Killerpk06/micromouse/kicad/micromouse_bom.csv

Reference | Value | Footprint | MPN | LCSC | Note | Qty
BZ1 | Magnetic 3V | Buzzer_Beeper:Buzzer_12x9.5RM7.6 |  |  |  | 1
C1 | 100uF 16V | Capacitor_Tantalum_SMD:CP_EIA-7343-31_Kemet-D |  |  |  | 1
C2,C3,C20 | 10uF 25V | Capacitor_SMD:C_1206_3216Metric |  |  |  | 3
C4,C7,C10,C11,C12,C15,C16,C19,C21,C23,C29,C31,C33,C35,C36,C38,C40,C42,C43,C44,C45,C46 | 100nF | Capacitor_SMD:C_0603_1608Metric |  |  |  | 22
C5,C6 | 22uF 10V | Capacitor_SMD:C_0805_2012Metric |  |  |  | 2
C8,C9,C14 | 1uF | Capacitor_SMD:C_0603_1608Metric |  |  |  | 3
C13,C28,C30,C32,C34 | 4.7uF | Capacitor_SMD:C_0603_1608Metric |  |  |  | 5
C17,C18 | 30pF C0G | Capacitor_SMD:C_0603_1608Metric |  |  |  | 2
C22 | 47uF 16V | Capacitor_Tantalum_SMD:CP_EIA-7343-31_Kemet-D |  |  |  | 1
C24,C25,C26,C27 | 100pF | Capacitor_SMD:C_0603_1608Metric |  |  |  | 4
C37 | 10nF | Capacitor_SMD:C_0603_1608Metric |  |  |  | 1
C39 | 2.2nF 50V | Capacitor_SMD:C_0603_1608Metric |  |  |  | 1
C41 | 4.7nF | Capacitor_SMD:C_0603_1608Metric |  |  |  | 1
D1 | Green | LED_SMD:LED_0603_1608Metric |  |  |  | 1
D2 | Blue | LED_SMD:LED_0603_1608Metric |  |  |  | 1
D3 | 1N4148W | Diode_SMD:D_SOD-123 | 1N4148W |  |  | 1
H1,H2,H3,H4 | M3 | MountingHole:MountingHole_3.2mm_M3_Pad_Via |  |  |  | 4
J1 | XT60PW-M | Connector_AMASS:AMASS_XT60PW-M_1x02_P7.20mm_Horizontal | XT60PW-M |  |  | 1
J2 | SWD 1.27mm | Connector_PinHeader_1.27mm:PinHeader_2x05_P1.27mm_Vertical_SMD |  |  |  | 1
J3 | SWD ST-Link | Connector_PinHeader_2.54mm:PinHeader_1x04_P2.54mm_Vertical |  |  |  | 1
J4 | MOTOR_L | Connector_JST:JST_PH_S6B-PH-K_1x06_P2.00mm_Horizontal | S6B-PH-K-S |  |  | 1
J5 | MOTOR_R | Connector_JST:JST_PH_S6B-PH-K_1x06_P2.00mm_Horizontal | S6B-PH-K-S |  |  | 1
J6 | FAN | Connector_JST:JST_PH_S2B-PH-K_1x02_P2.00mm_Horizontal | S2B-PH-K-S |  |  | 1
J7 | USB-C | Connector_USB:USB_C_Receptacle_GCT_USB4105-xx-A_16P_TopMnt_Horizontal | USB4105-GF-A |  |  | 1
J8 | OLED SSD1306 0.96in | Connector_PinHeader_2.54mm:PinHeader_1x04_P2.54mm_Vertical |  |  | Off-board 0.96in SSD1306 128x64 I2C module, addr 0x3C. REMOVE module SCL/SDA pull-ups: bus is 2.8V (+2V8 pull-ups R18/R19) | 1
L1 | 3.9uH | Inductor_SMD:L_Taiyo-Yuden_NR-40xx | NR4018T3R9M |  |  | 1
Q1 | AO3400A | Package_TO_SOT_SMD:SOT-23 | AO3400A |  |  | 1
Q2 | MMBT3904 | Package_TO_SOT_SMD:SOT-23 | MMBT3904 |  |  | 1
R1 | 20k 1% | Resistor_SMD:R_0603_1608Metric |  |  |  | 1
R2 | 10k 1% | Resistor_SMD:R_0603_1608Metric |  |  |  | 1
R3,R35,R36 | 1k | Resistor_SMD:R_0603_1608Metric |  |  |  | 3
R4,R5,R6,R7,R8,R9,R10,R11,R20,R21,R24,R25,R26,R33,R34,R37,R38,R39,R40 | 10k | Resistor_SMD:R_0603_1608Metric |  |  |  | 19
R12,R13,R14,R15 | 4.7k | Resistor_SMD:R_0603_1608Metric |  |  |  | 4
R16 | 100 | Resistor_SMD:R_0603_1608Metric |  |  |  | 1
R17 | 100k | Resistor_SMD:R_0603_1608Metric |  |  |  | 1
R18,R19 | 2.2k | Resistor_SMD:R_0603_1608Metric |  |  |  | 2
R22,R23 | 47k | Resistor_SMD:R_0603_1608Metric |  |  |  | 2
R27,R28 | 5.1k | Resistor_SMD:R_0603_1608Metric |  |  |  | 2
R29 | 1M | Resistor_SMD:R_0603_1608Metric |  |  |  | 1
R30,R31 | 22 | Resistor_SMD:R_0603_1608Metric |  |  |  | 2
R32 | 1.5k | Resistor_SMD:R_0603_1608Metric |  |  |  | 1
SW1 | PCM12SMTR | Button_Switch_SMD:SW_SPDT_PCM12 | PCM12SMTR |  |  | 1
SW2 | RESET | Button_Switch_SMD:SW_SPST_TL3342 | TL3342F160QG |  |  | 1
SW3 | SW_A | Button_Switch_SMD:SW_SPST_TL3342 | TL3342F160QG |  |  | 1
SW4 | SW_B | Button_Switch_SMD:SW_SPST_TL3342 | TL3342F160QG |  |  | 1
SW5 | SW_UP | Button_Switch_SMD:SW_SPST_TL3342 | TL3342F160QG |  |  | 1
SW6 | SW_DOWN | Button_Switch_SMD:SW_SPST_TL3342 | TL3342F160QG |  |  | 1
SW7 | SW_BACK | Button_Switch_SMD:SW_SPST_TL3342 | TL3342F160QG |  |  | 1
SW8 | SW_ENTER | Button_Switch_SMD:SW_SPST_TL3342 | TL3342F160QG |  |  | 1
TP1 | VBAT_SW | TestPoint:TestPoint_Pad_D1.5mm |  |  |  | 1
TP2 | +3V3 | TestPoint:TestPoint_Pad_D1.5mm |  |  |  | 1
TP3,TP21 | GND | TestPoint:TestPoint_Pad_D1.5mm |  |  |  | 2
TP4 | BOOT0 | TestPoint:TestPoint_Pad_D1.5mm |  |  |  | 1
TP5 | BTN_UP | TestPoint:TestPoint_Pad_D1.5mm |  |  |  | 1
TP6 | BTN_DOWN | TestPoint:TestPoint_Pad_D1.5mm |  |  |  | 1
TP7 | BTN_BACK | TestPoint:TestPoint_Pad_D1.5mm |  |  |  | 1
TP8 | BTN_ENTER | TestPoint:TestPoint_Pad_D1.5mm |  |  |  | 1
TP9 | SPARE_PB1 | TestPoint:TestPoint_Pad_D1.5mm |  |  |  | 1
TP10 | I2C1_SCL | TestPoint:TestPoint_Pad_D1.5mm |  |  |  | 1
TP11 | I2C1_SDA | TestPoint:TestPoint_Pad_D1.5mm |  |  |  | 1
TP12 | TOF_XSHUT_FL | TestPoint:TestPoint_Pad_D1.5mm |  |  |  | 1
TP13 | TOF_GPIO1_FL | TestPoint:TestPoint_Pad_D1.5mm |  |  |  | 1
TP14 | TOF_XSHUT_FR | TestPoint:TestPoint_Pad_D1.5mm |  |  |  | 1
TP15 | TOF_GPIO1_FR | TestPoint:TestPoint_Pad_D1.5mm |  |  |  | 1
TP16 | TOF_XSHUT_L | TestPoint:TestPoint_Pad_D1.5mm |  |  |  | 1
TP17 | TOF_GPIO1_L | TestPoint:TestPoint_Pad_D1.5mm |  |  |  | 1
TP18 | TOF_XSHUT_R | TestPoint:TestPoint_Pad_D1.5mm |  |  |  | 1
TP19 | TOF_GPIO1_R | TestPoint:TestPoint_Pad_D1.5mm |  |  |  | 1
TP20 | IMU_INT | TestPoint:TestPoint_Pad_D1.5mm |  |  |  | 1
U1 | AP63203WU-7 | Package_TO_SOT_SMD:TSOT-23-6 | AP63203WU-7 |  |  | 1
U2 | ME6211C28M5G-N | Package_TO_SOT_SMD:SOT-23-5 | ME6211C28M5G-N |  |  | 1
U3 | STM32F103C8T6 | Package_QFP:LQFP-48_7x7mm_P0.5mm | STM32F103C8T6 |  |  | 1
U4 | TB6612FNG | Package_SO:SSOP-24_5.3x8.2mm_P0.65mm | TB6612FNG,C,8,EL |  |  | 1
U5,U6 | VL53L0X | Sensor_Distance:ST_VL53L1x | VL53L0CXV0DH/1 |  |  | 2
U7,U8 | VL6180X | micromouse:ST_VL6180X_LGA-12 | VL6180XV0NR/1 |  |  | 2
U9 | MPU-6050 | Sensor_Motion:InvenSense_QFN-24_4x4mm_P0.5mm | MPU-6050 |  |  | 1
U10 | W25Q32JVSSIQ | Package_SO:SOIC-8_5.3x5.3mm_P1.27mm | W25Q32JVSSIQ |  |  | 1
Y1 | 8MHz CL=20pF | Crystal:Crystal_SMD_3225-4Pin_3.2x2.5mm | X322508MSB4SI |  |  | 1
