Killerpk06/micromouse/kicad/micromouse.kicad_sch

## KiCad design kicad/micromouse.kicad_sch (2026-10-27)

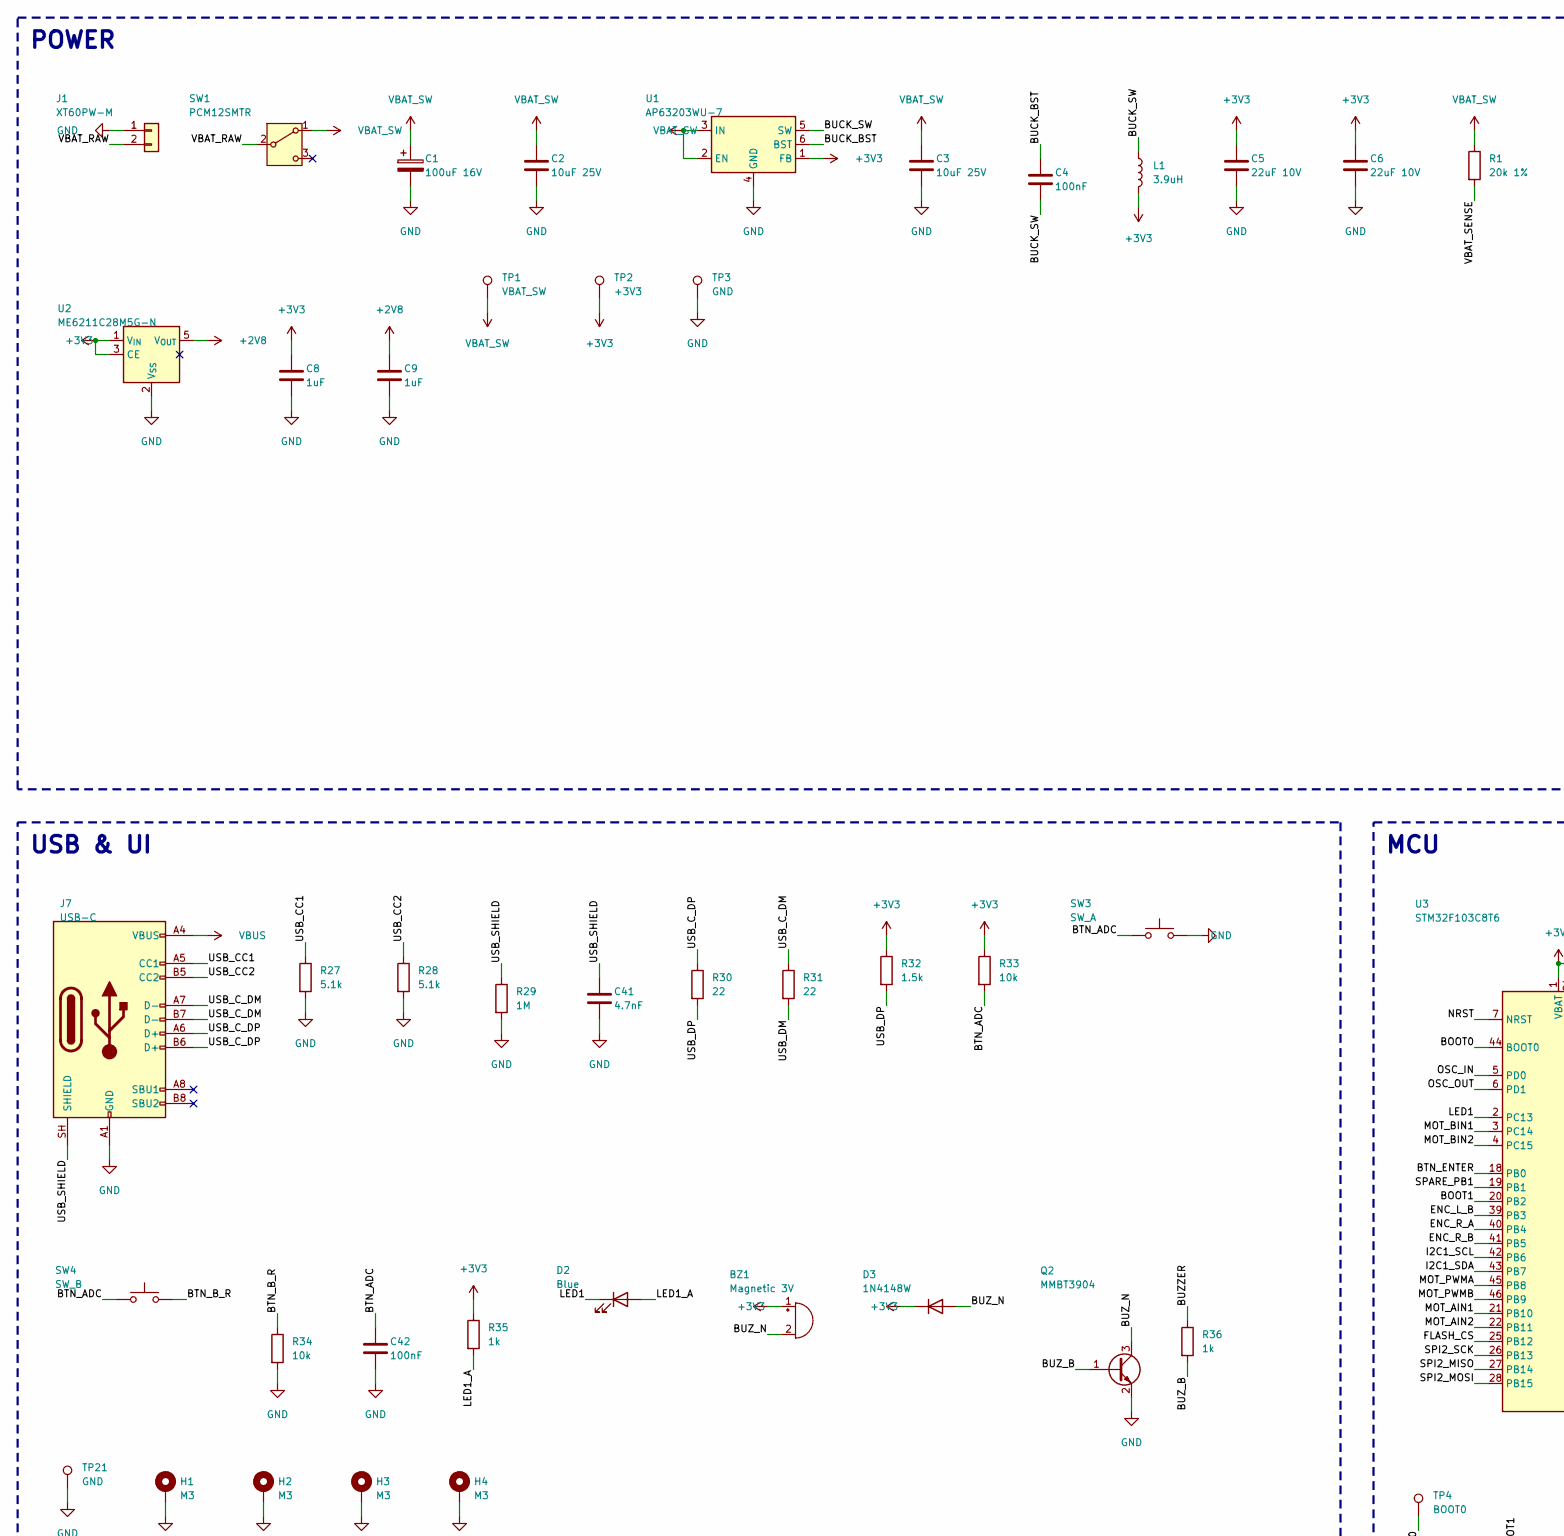
[picture p1: schematic micromouse.kicad_sch, part in row 1, column 1]

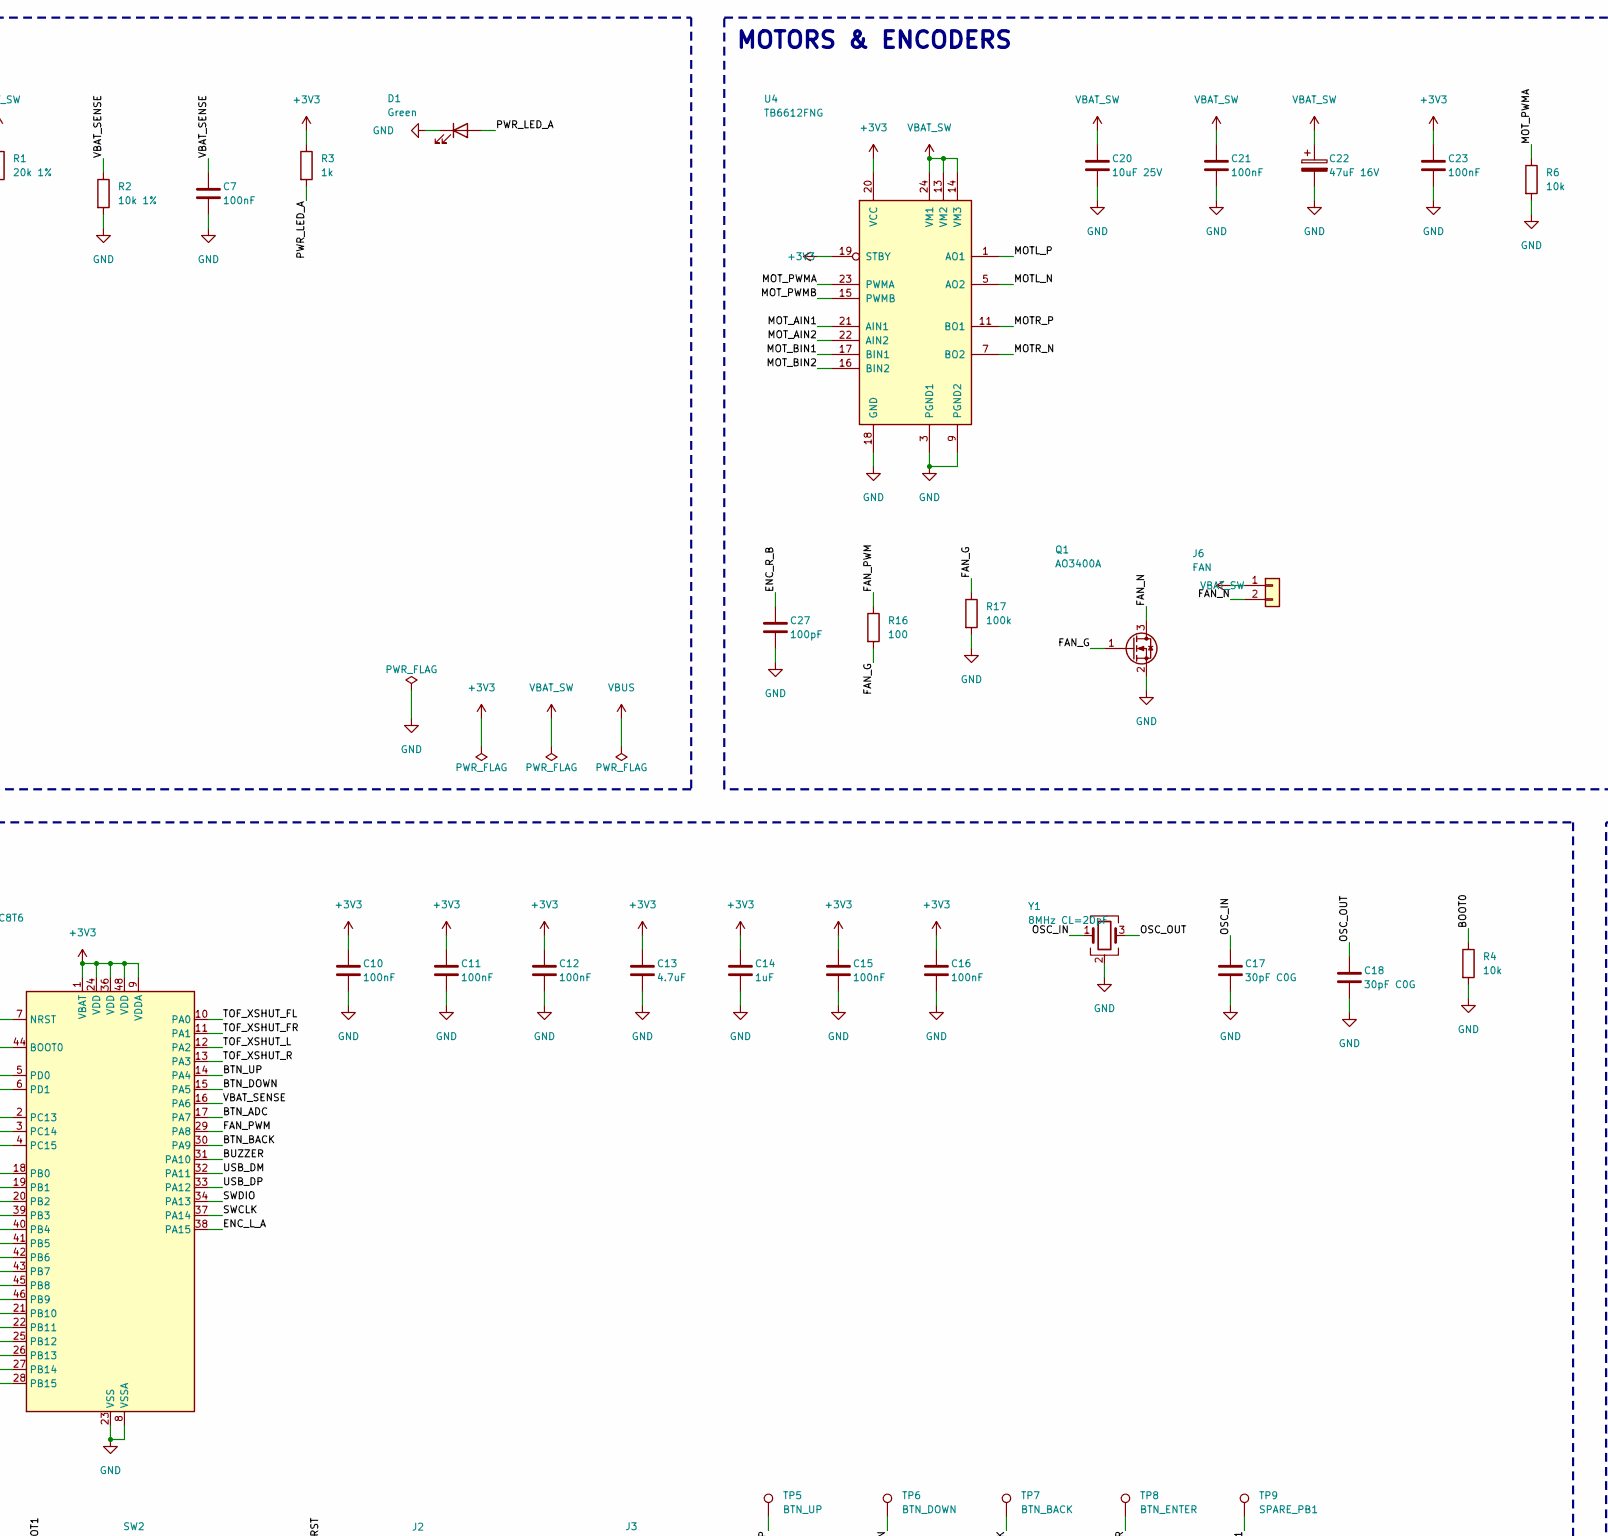
[picture p2: schematic micromouse.kicad_sch, part in row 1, column 2]

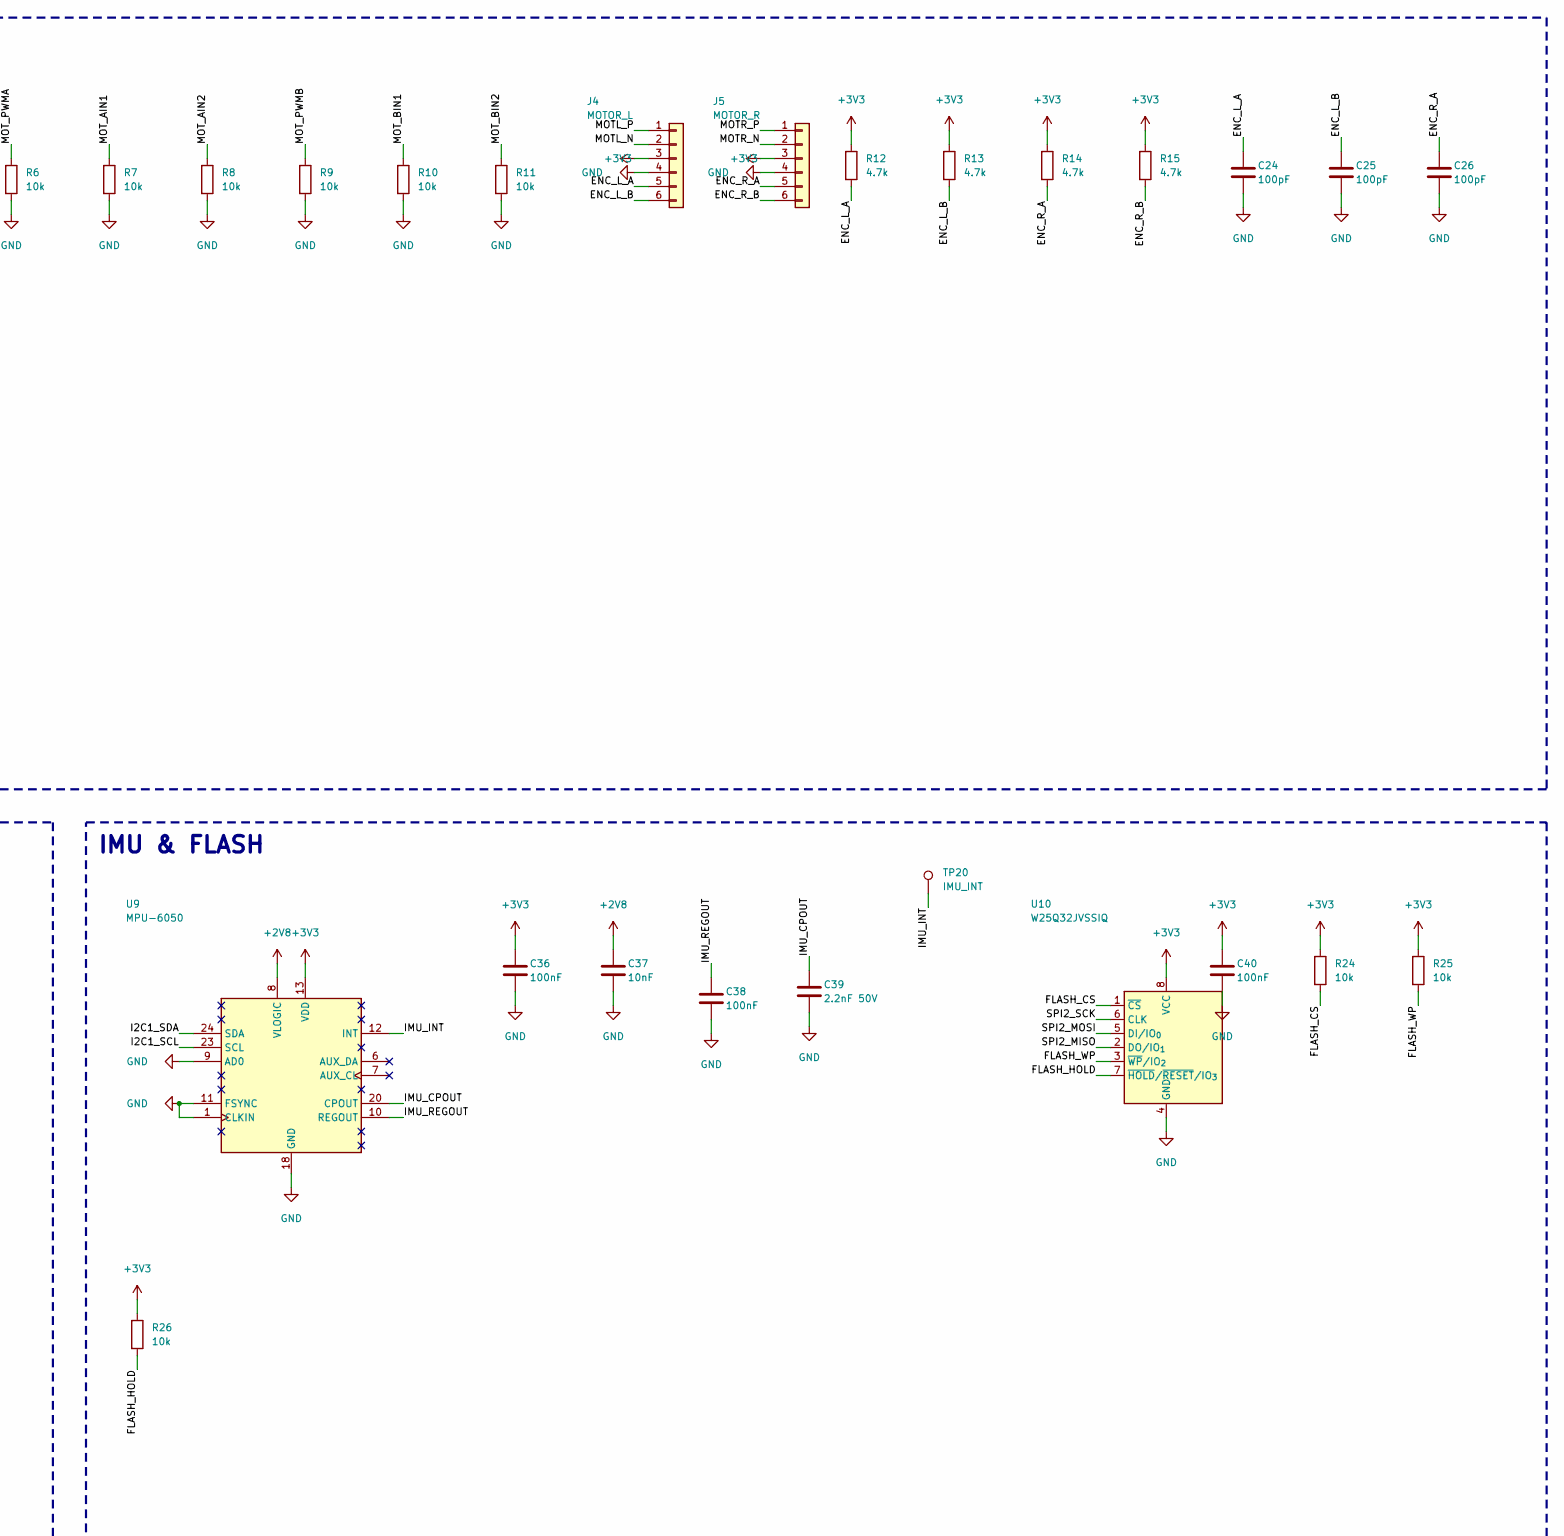
[picture p3: schematic micromouse.kicad_sch, part in row 1, column 3]

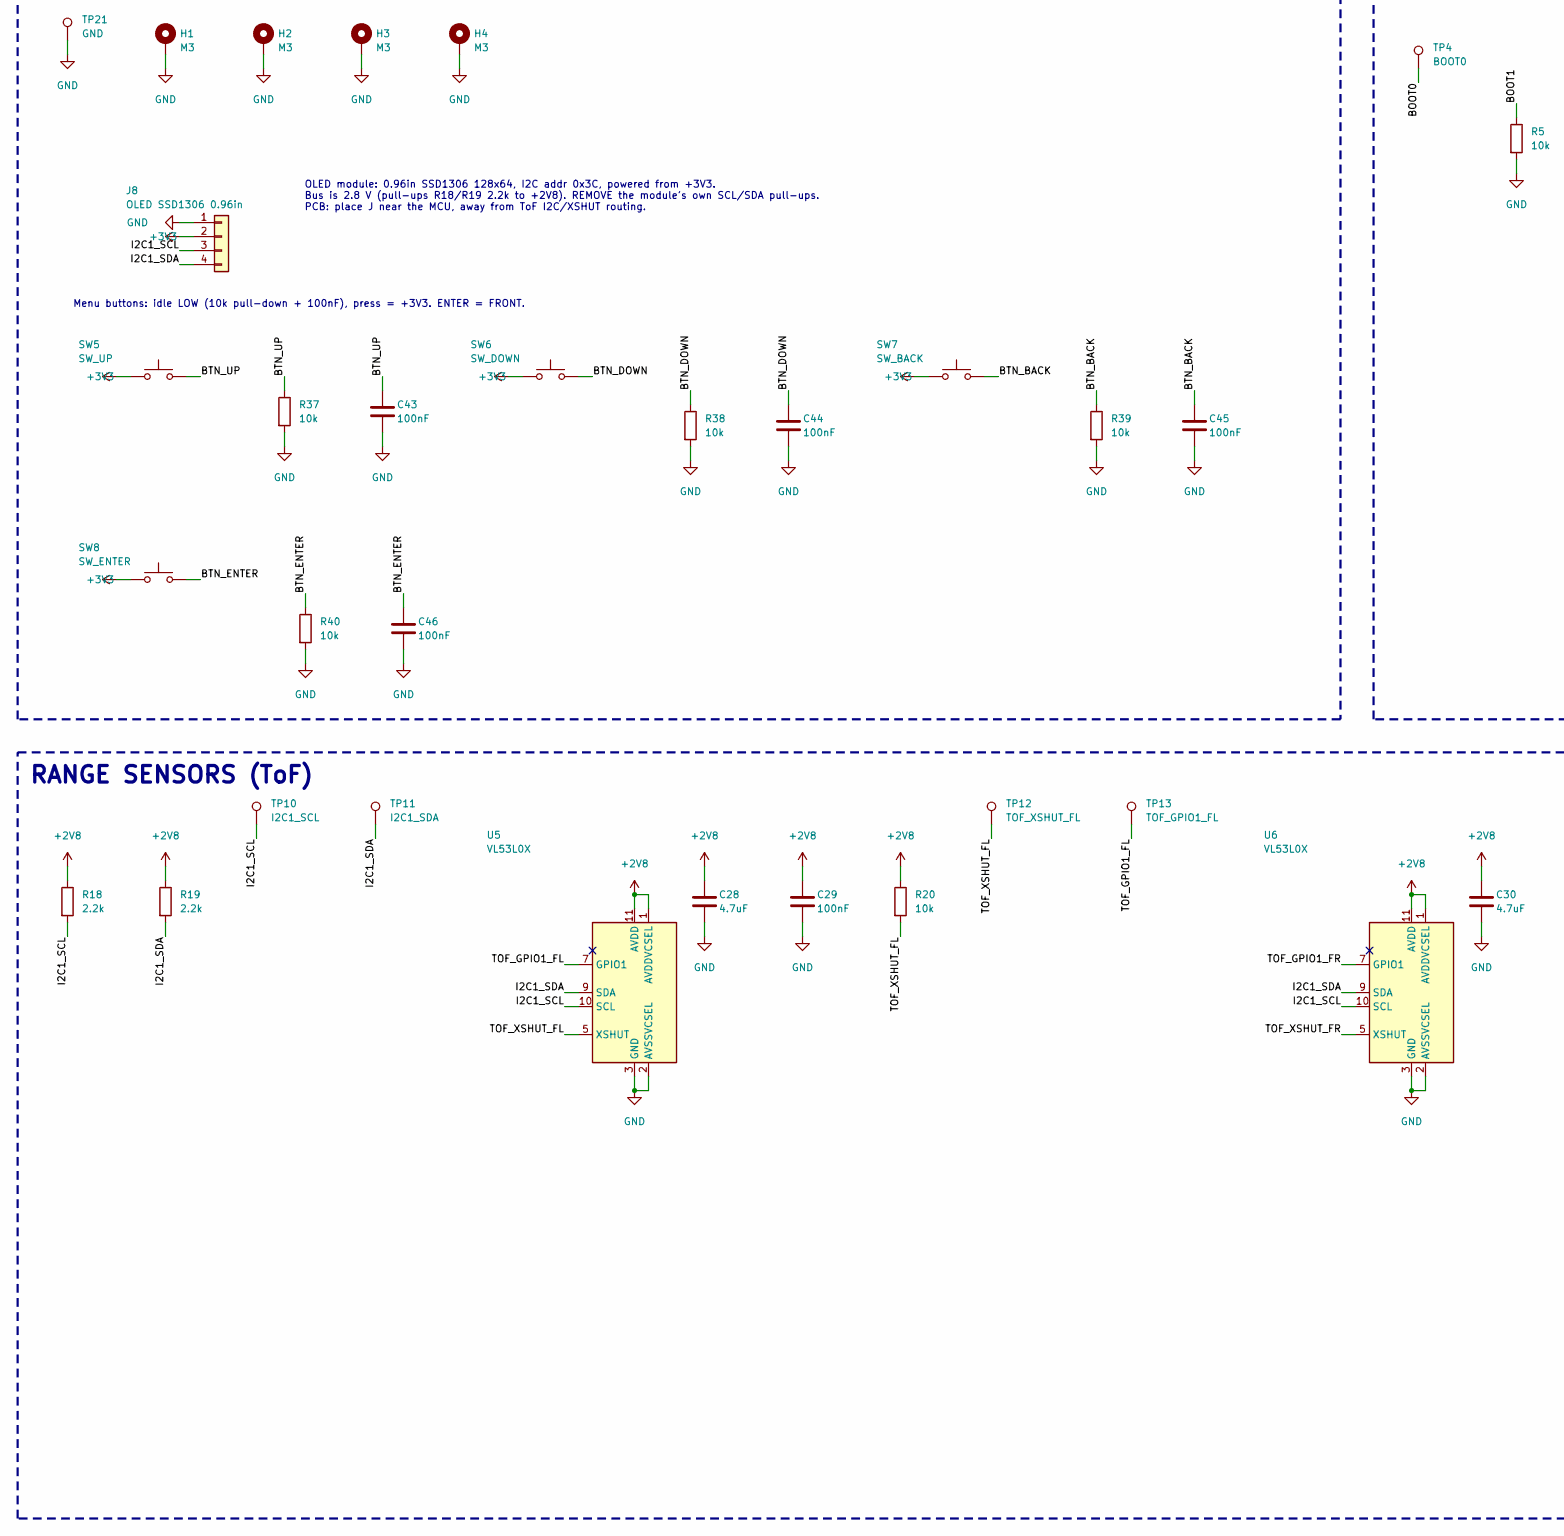
[picture p4: schematic micromouse.kicad_sch, part in row 2, column 1]

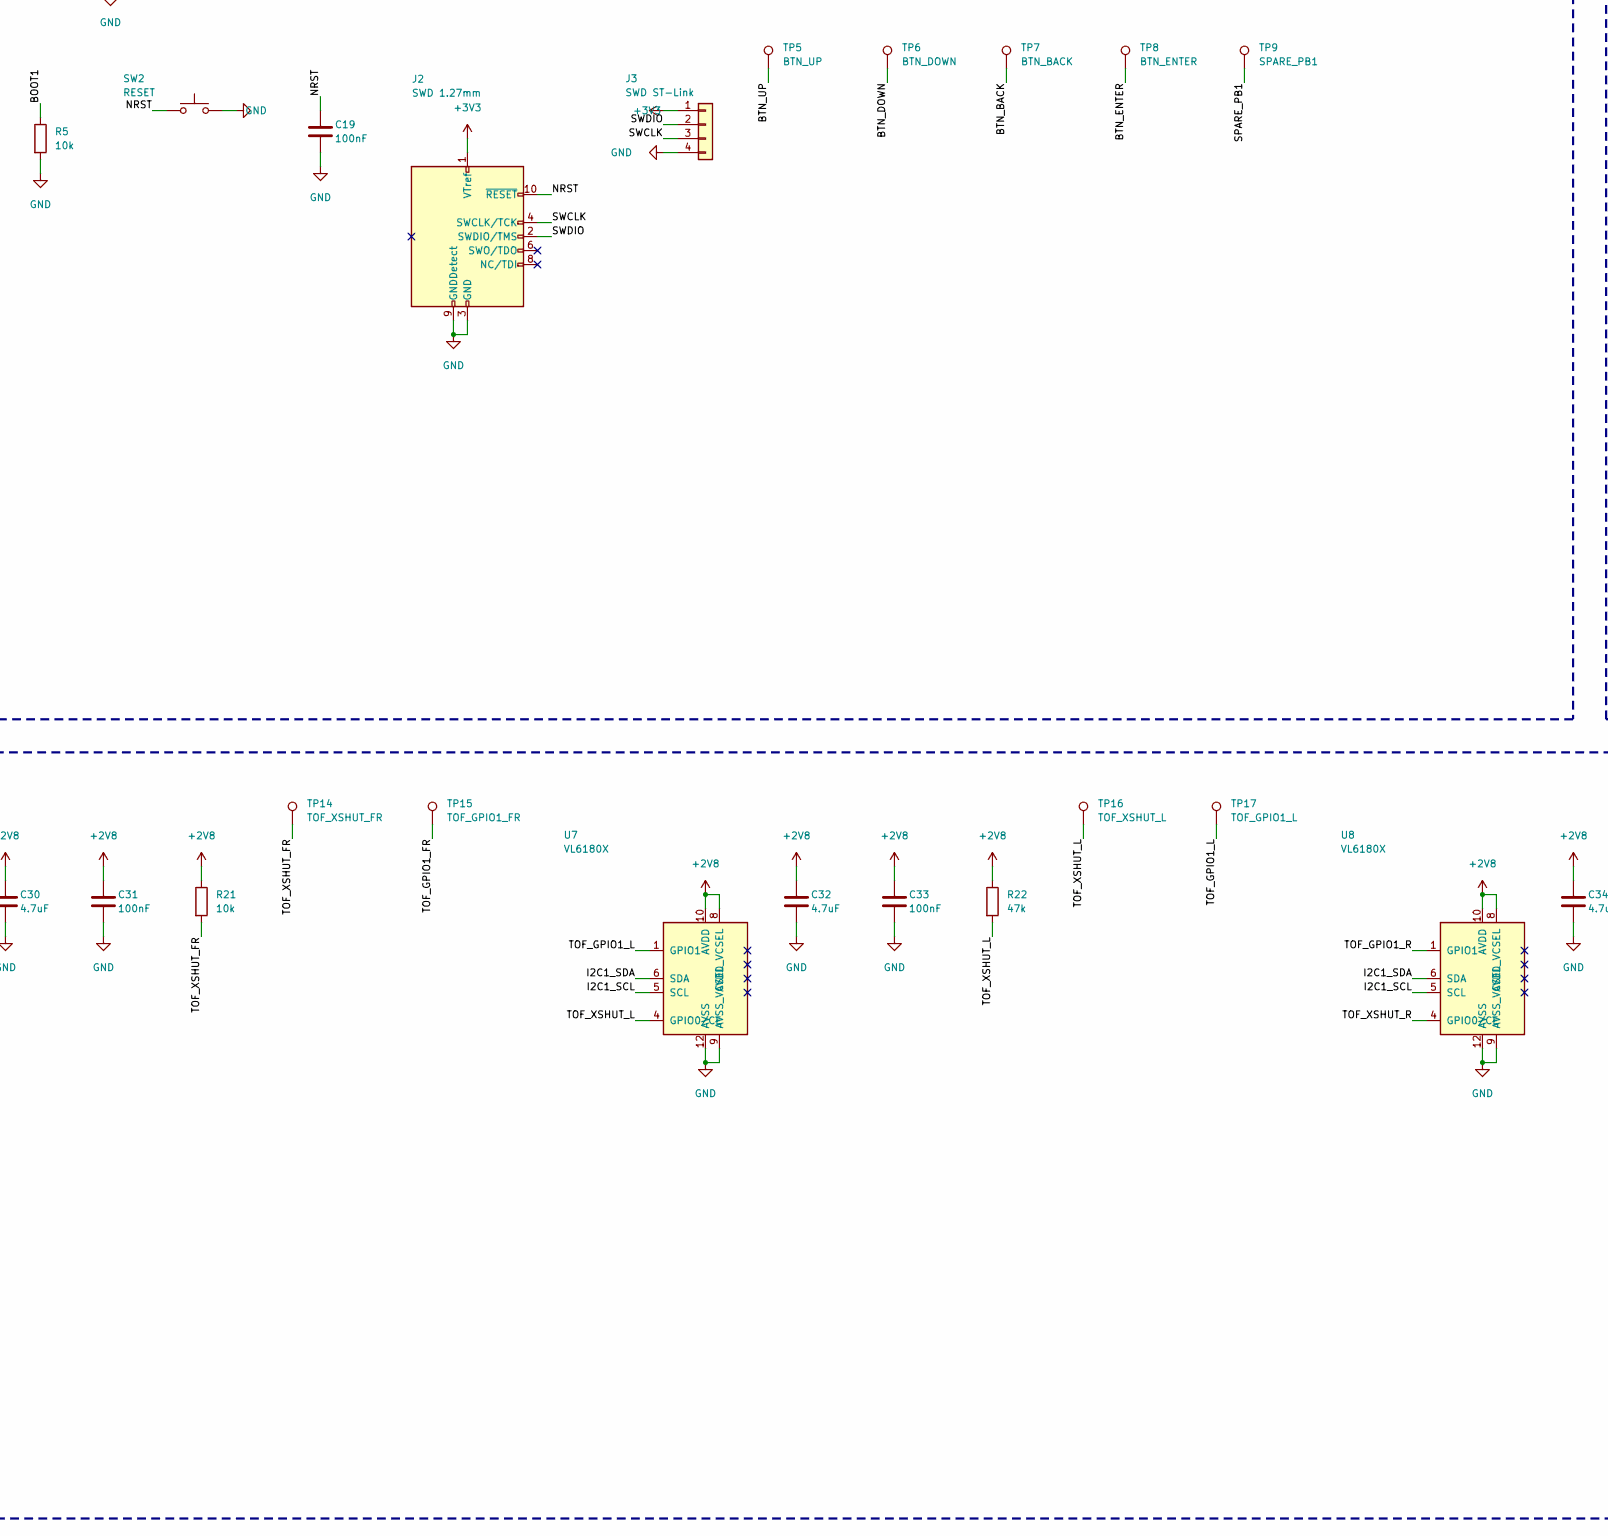
[picture p5: schematic micromouse.kicad_sch, part in row 2, column 2]

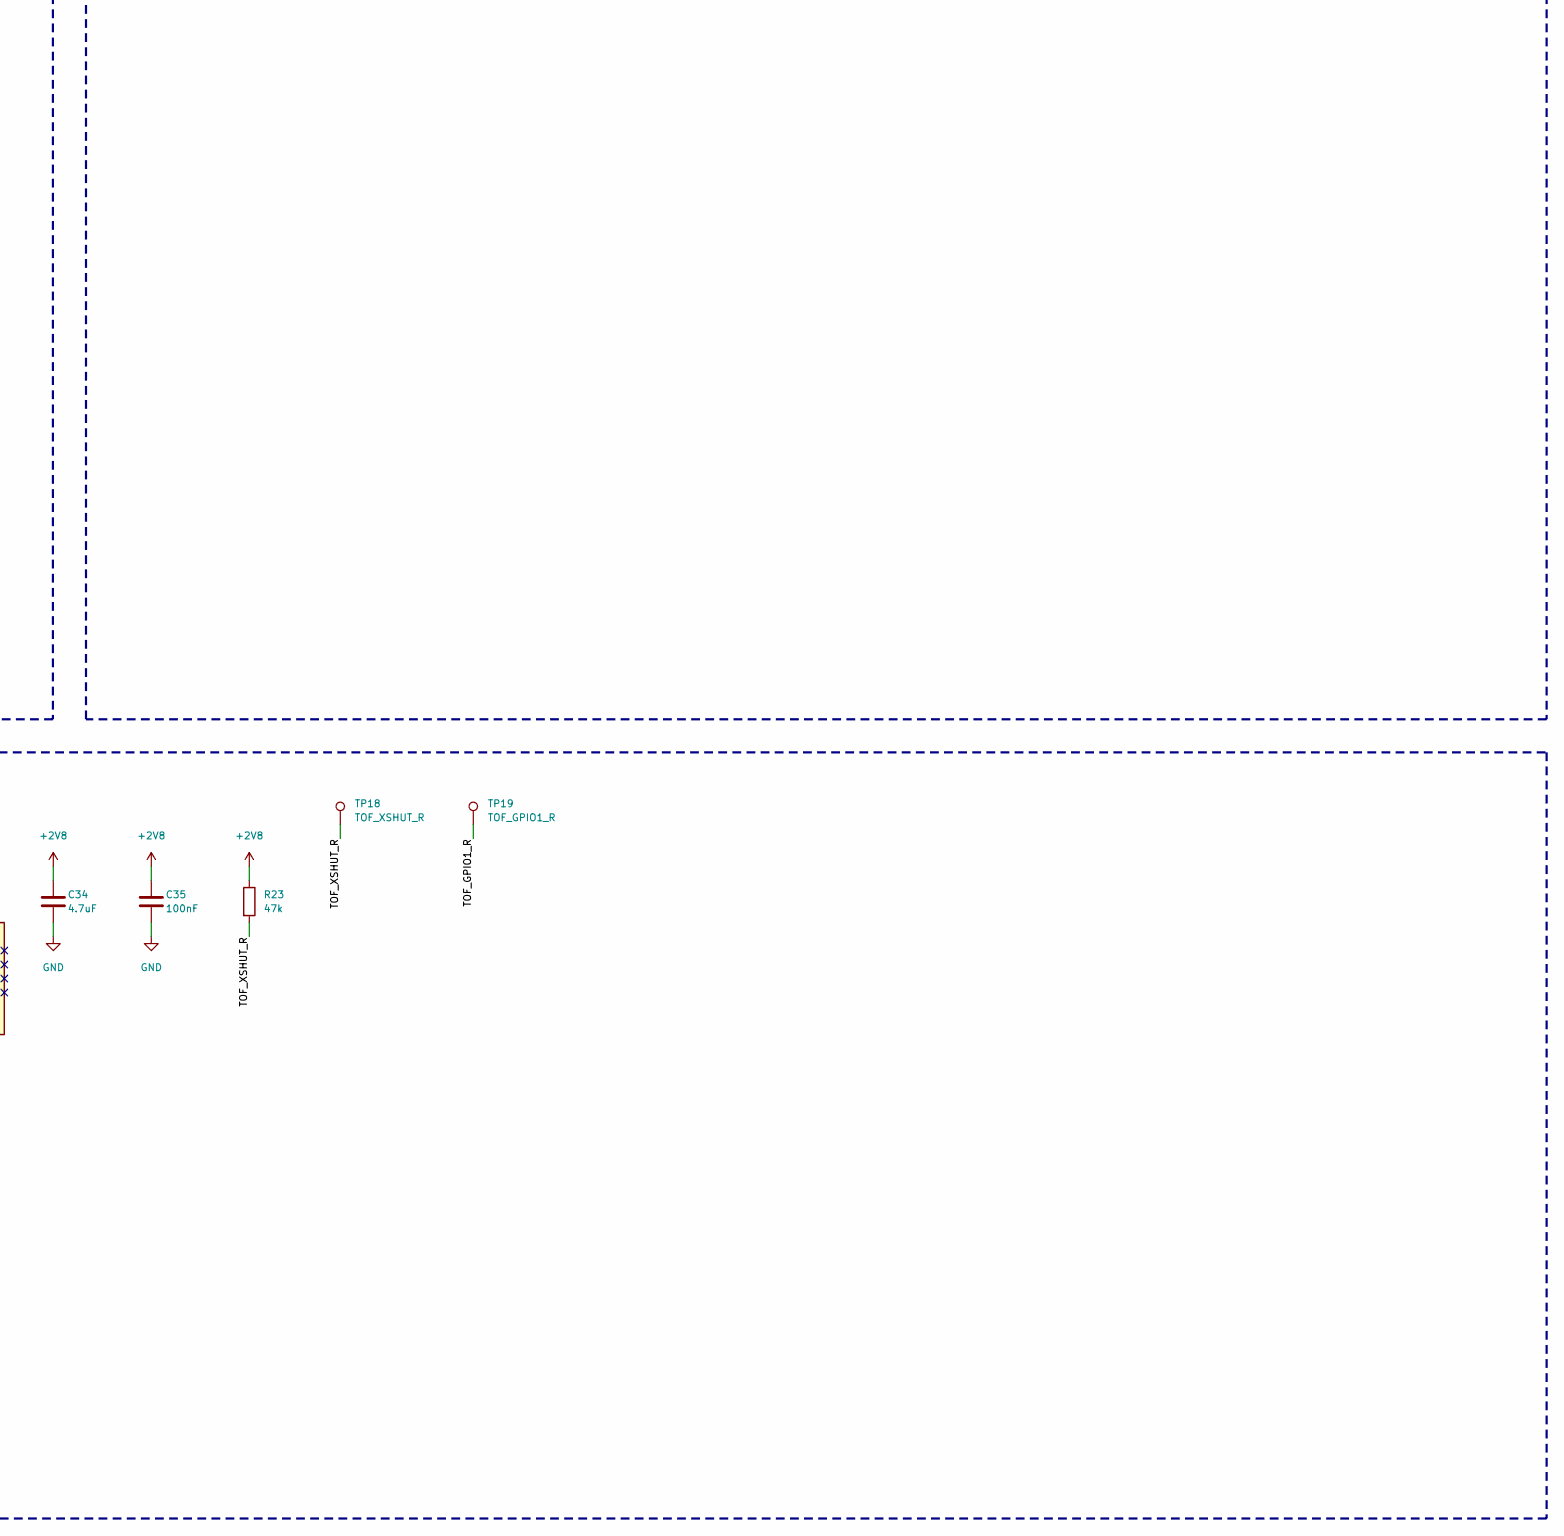
[picture p6: schematic micromouse.kicad_sch, part in row 2, column 3]

Parts:
BZ1: Magnetic 3V; Buzzer_12x9.5RM7.6
C1: 100uF 16V; CP_EIA-7343-31_Kemet-D
C2, C3, C20: 10uF 25V; C_1206_3216Metric
C4, C7, C10, C11, C12, C15, C16, C19, C21, C23, C29, C31, C33, C35, C36, C38, C40, C42, C43, C44, C45, C46: 100nF; C_0603_1608Metric
C5, C6: 22uF 10V; C_0805_2012Metric
C8, C9, C14: 1uF; C_0603_1608Metric
C13, C28, C30, C32, C34: 4.7uF; C_0603_1608Metric
C17, C18: 30pF C0G; C_0603_1608Metric
C22: 47uF 16V; CP_EIA-7343-31_Kemet-D
C24, C25, C26, C27: 100pF; C_0603_1608Metric
C37: 10nF; C_0603_1608Metric
C39: 2.2nF 50V; C_0603_1608Metric
C41: 4.7nF; C_0603_1608Metric
D1: Green; LED_0603_1608Metric
D2: Blue; LED_0603_1608Metric
D3: 1N4148W; D_SOD-123; MPN 1N4148W
H1, H2, H3, H4: M3; MountingHole_3.2mm_M3_Pad_Via
J1: XT60PW-M; AMASS_XT60PW-M_1x02_P7.20mm_Horizontal; MPN XT60PW-M
J2: SWD 1.27mm; PinHeader_2x05_P1.27mm_Vertical_SMD
J3: SWD ST-Link; PinHeader_1x04_P2.54mm_Vertical
J4: MOTOR_L; JST_PH_S6B-PH-K_1x06_P2.00mm_Horizontal; MPN S6B-PH-K-S
J5: MOTOR_R; JST_PH_S6B-PH-K_1x06_P2.00mm_Horizontal; MPN S6B-PH-K-S
J6: FAN; JST_PH_S2B-PH-K_1x02_P2.00mm_Horizontal; MPN S2B-PH-K-S
J7: USB-C; USB_C_Receptacle_GCT_USB4105-xx-A_16P_TopMnt_Horizontal; MPN USB4105-GF-A
J8: OLED SSD1306 0.96in; PinHeader_1x04_P2.54mm_Vertical
L1: 3.9uH; L_Taiyo-Yuden_NR-40xx; MPN NR4018T3R9M
Q1: AO3400A; SOT-23; MPN AO3400A
Q2: MMBT3904; SOT-23; MPN MMBT3904
R1: 20k 1%; R_0603_1608Metric
R2: 10k 1%; R_0603_1608Metric
R3, R35, R36: 1k; R_0603_1608Metric
R4, R5, R6, R7, R8, R9, R10, R11, R20, R21, R24, R25, R26, R33, R34, R37, R38, R39, R40: 10k; R_0603_1608Metric
R12, R13, R14, R15: 4.7k; R_0603_1608Metric
R16: 100; R_0603_1608Metric
R17: 100k; R_0603_1608Metric
R18, R19: 2.2k; R_0603_1608Metric
R22, R23: 47k; R_0603_1608Metric
R27, R28: 5.1k; R_0603_1608Metric
R29: 1M; R_0603_1608Metric
R30, R31: 22; R_0603_1608Metric
R32: 1.5k; R_0603_1608Metric
SW1: PCM12SMTR; SW_SPDT_PCM12; MPN PCM12SMTR
SW2: RESET; SW_SPST_TL3342; MPN TL3342F160QG
SW3: SW_A; SW_SPST_TL3342; MPN TL3342F160QG
SW4: SW_B; SW_SPST_TL3342; MPN TL3342F160QG
SW5: SW_UP; SW_SPST_TL3342; MPN TL3342F160QG
SW6: SW_DOWN; SW_SPST_TL3342; MPN TL3342F160QG
SW7: SW_BACK; SW_SPST_TL3342; MPN TL3342F160QG
SW8: SW_ENTER; SW_SPST_TL3342; MPN TL3342F160QG
TP1: VBAT_SW; TestPoint_Pad_D1.5mm
TP2: +3V3; TestPoint_Pad_D1.5mm
TP3, TP21: GND; TestPoint_Pad_D1.5mm
TP4: BOOT0; TestPoint_Pad_D1.5mm
TP5: BTN_UP; TestPoint_Pad_D1.5mm
TP6: BTN_DOWN; TestPoint_Pad_D1.5mm
TP7: BTN_BACK; TestPoint_Pad_D1.5mm
TP8: BTN_ENTER; TestPoint_Pad_D1.5mm
TP9: SPARE_PB1; TestPoint_Pad_D1.5mm
TP10: I2C1_SCL; TestPoint_Pad_D1.5mm
TP11: I2C1_SDA; TestPoint_Pad_D1.5mm
TP12: TOF_XSHUT_FL; TestPoint_Pad_D1.5mm
TP13: TOF_GPIO1_FL; TestPoint_Pad_D1.5mm
TP14: TOF_XSHUT_FR; TestPoint_Pad_D1.5mm
TP15: TOF_GPIO1_FR; TestPoint_Pad_D1.5mm
TP16: TOF_XSHUT_L; TestPoint_Pad_D1.5mm
TP17: TOF_GPIO1_L; TestPoint_Pad_D1.5mm
TP18: TOF_XSHUT_R; TestPoint_Pad_D1.5mm
TP19: TOF_GPIO1_R; TestPoint_Pad_D1.5mm
TP20: IMU_INT; TestPoint_Pad_D1.5mm
U1: AP63203WU-7; TSOT-23-6; MPN AP63203WU-7
U2: ME6211C28M5G-N; SOT-23-5; MPN ME6211C28M5G-N
U3: STM32F103C8T6; LQFP-48_7x7mm_P0.5mm; MPN STM32F103C8T6
U4: TB6612FNG; SSOP-24_5.3x8.2mm_P0.65mm; MPN TB6612FNG,C,8,EL
U5, U6: VL53L0X; ST_VL53L1x; MPN VL53L0CXV0DH/1
U7, U8: VL6180X; ST_VL6180X_LGA-12; MPN VL6180XV0NR/1
U9: MPU-6050; InvenSense_QFN-24_4x4mm_P0.5mm; MPN MPU-6050
U10: W25Q32JVSSIQ; SOIC-8_5.3x5.3mm_P1.27mm; MPN W25Q32JVSSIQ
Y1: 8MHz CL=20pF; Crystal_SMD_3225-4Pin_3.2x2.5mm; MPN X322508MSB4SI

Connections:
+2V8: C9.1, C28.1, C29.1, C30.1, C31.1, C32.1, C33.1, C34.1, C35.1, C37.1, R18.1, R19.1, R20.1, R21.1, R22.1, R23.1, U2.5 (V_{OUT}), U5.1 (AVDDVCSEL), U5.11 (AVDD), U6.1 (AVDDVCSEL), U6.11 (AVDD), U7.8 (AVDD_VCSEL), U7.10 (AVDD), U8.8 (AVDD_VCSEL), U8.10 (AVDD), U9.8 (VLOGIC)
+3V3: BZ1.1 (+), C5.1, C6.1, C8.1, C10.1, C11.1, C12.1, C13.1, C14.1, C15.1, C16.1, C23.1, C36.1, C40.1, D3.1 (K), J2.1 (VTref), J3.1, J4.3, J5.3, J8.2, L1.2, R3.1, R12.1, R13.1, R14.1, R15.1, R24.1, R25.1, R26.1, R32.1, R33.1, R35.1, SW5.1, SW6.1, SW7.1, SW8.1, TP2.1, U1.1 (FB), U2.1 (V_{IN}), U2.3 (CE), U3.1 (VBAT), U3.9 (VDDA), U3.24 (VDD), U3.36 (VDD), U3.48 (VDD), U4.19 (STBY), U4.20 (VCC), U9.13 (VDD), U10.8 (VCC)
BOOT0: R4.1, TP4.1, U3.44 (BOOT0)
BOOT1: R5.1, U3.20 (PB2)
BTN_ADC: C42.1, R33.2, SW3.1, SW4.1, U3.17 (PA7)
BTN_BACK: C45.1, R39.1, SW7.2, TP7.1, U3.30 (PA9)
BTN_B_R: R34.1, SW4.2
BTN_DOWN: C44.1, R38.1, SW6.2, TP6.1, U3.15 (PA5)
BTN_ENTER: C46.1, R40.1, SW8.2, TP8.1, U3.18 (PB0)
BTN_UP: C43.1, R37.1, SW5.2, TP5.1, U3.14 (PA4)
BUCK_BST: C4.1, U1.6 (BST)
BUCK_SW: C4.2, L1.1, U1.5 (SW)
BUZZER: R36.1, U3.31 (PA10)
BUZ_B: Q2.1 (B), R36.2
BUZ_N: BZ1.2 (-), D3.2 (A), Q2.3 (C)
ENC_L_A: C24.1, J4.5, R12.2, U3.38 (PA15)
ENC_L_B: C25.1, J4.6, R13.2, U3.39 (PB3)
ENC_R_A: C26.1, J5.5, R14.2, U3.40 (PB4)
ENC_R_B: C27.1, J5.6, R15.2, U3.41 (PB5)
FAN_G: Q1.1 (G), R16.2, R17.1
FAN_N: J6.2, Q1.3 (D)
FAN_PWM: R16.1, U3.29 (PA8)
FLASH_CS: R24.2, U3.25 (PB12), U10.1 (~CS)
FLASH_HOLD: R26.2, U10.7 (~HOLD/~RESET/IO_{3})
FLASH_WP: R25.2, U10.3 (~WP/IO_{2})
GND: C1.2, C2.2, C3.2, C5.2, C6.2, C7.2, C8.2, C9.2, C10.2, C11.2, C12.2, C13.2, C14.2, C15.2, C16.2, C17.2, C18.2, C19.2, C20.2, C21.2, C22.2, C23.2, C24.2, C25.2, C26.2, C27.2, C28.2, C29.2, C30.2, C31.2, C32.2, C33.2, C34.2, C35.2, C36.2, C37.2, C38.2, C39.2, C40.2, C41.2, C42.2, C43.2, C44.2, C45.2, C46.2, D1.1 (K), H1.1, H2.1, H3.1, H4.1, J1.1, J2.3 (GND), J2.5 (GND), J2.9 (GNDDetect), J3.4, J4.4, J5.4, J7.A1 (GND), J7.A12 (GND), J7.B1 (GND), J7.B12 (GND), J8.1, Q1.2 (S), Q2.2 (E), R2.2, R4.2, R5.2, R6.2, R7.2, R8.2, R9.2, R10.2, R11.2, R17.2, R27.2, R28.2, R29.2, R34.2, R37.2, R38.2, R39.2, R40.2, SW2.2, SW3.2, TP3.1, TP21.1, U1.4 (GND), U2.2 (V_{SS}), U3.8 (VSSA), U3.23 (VSS), U3.35 (VSS), U3.47 (VSS), U4.3 (PGND1), U4.4 (PGND1), U4.9 (PGND2), U4.10 (PGND2), U4.18 (GND), U5.2 (AVSSVCSEL), U5.3 (GND), U5.4 (GND), U5.6 (GND), U5.12 (GND), U6.2 (AVSSVCSEL), U6.3 (GND), U6.4 (GND), U6.6 (GND), U6.12 (GND), U7.9 (AVSS_VCSEL), U7.12 (AVSS), U8.9 (AVSS_VCSEL), U8.12 (AVSS), U9.1 (CLKIN), U9.9 (AD0), U9.11 (FSYNC), U9.18 (GND), U10.4 (GND), Y1.2 (G), Y1.4 (G)
I2C1_SCL: J8.3, R18.2, TP10.1, U3.42 (PB6), U5.10 (SCL), U6.10 (SCL), U7.5 (SCL), U8.5 (SCL), U9.23 (SCL)
I2C1_SDA: J8.4, R19.2, TP11.1, U3.43 (PB7), U5.9 (SDA), U6.9 (SDA), U7.6 (SDA), U8.6 (SDA), U9.24 (SDA)
IMU_CPOUT: C39.1, U9.20 (CPOUT)
IMU_INT: TP20.1, U9.12 (INT)
IMU_REGOUT: C38.1, U9.10 (REGOUT)
LED1: D2.1 (K), U3.2 (PC13)
LED1_A: D2.2 (A), R35.2
MOTL_N: J4.2, U4.5 (AO2), U4.6 (AO2)
MOTL_P: J4.1, U4.1 (AO1), U4.2 (AO1)
MOTR_N: J5.2, U4.7 (BO2), U4.8 (BO2)
MOTR_P: J5.1, U4.11 (BO1), U4.12 (BO1)
MOT_AIN1: R7.1, U3.21 (PB10), U4.21 (AIN1)
MOT_AIN2: R8.1, U3.22 (PB11), U4.22 (AIN2)
MOT_BIN1: R10.1, U3.3 (PC14), U4.17 (BIN1)
MOT_BIN2: R11.1, U3.4 (PC15), U4.16 (BIN2)
MOT_PWMA: R6.1, U3.45 (PB8), U4.23 (PWMA)
MOT_PWMB: R9.1, U3.46 (PB9), U4.15 (PWMB)
NRST: C19.1, J2.10 (~RESET), SW2.1, U3.7 (NRST)
OSC_IN: C17.1, U3.5 (PD0), Y1.1
OSC_OUT: C18.1, U3.6 (PD1), Y1.3
PWR_LED_A: D1.2 (A), R3.2
SPARE_PB1: TP9.1, U3.19 (PB1)
SPI2_MISO: U3.27 (PB14), U10.2 (DO/IO_{1})
SPI2_MOSI: U3.28 (PB15), U10.5 (DI/IO_{0})
SPI2_SCK: U3.26 (PB13), U10.6 (CLK)
SWCLK: J2.4 (SWCLK/TCK), J3.3, U3.37 (PA14)
SWDIO: J2.2 (SWDIO/TMS), J3.2, U3.34 (PA13)
TOF_GPIO1_FL: TP13.1, U5.7 (GPIO1)
TOF_GPIO1_FR: TP15.1, U6.7 (GPIO1)
TOF_GPIO1_L: TP17.1, U7.1 (GPIO1)
TOF_GPIO1_R: TP19.1, U8.1 (GPIO1)
TOF_XSHUT_FL: R20.2, TP12.1, U3.10 (PA0), U5.5 (XSHUT)
TOF_XSHUT_FR: R21.2, TP14.1, U3.11 (PA1), U6.5 (XSHUT)
TOF_XSHUT_L: R22.2, TP16.1, U3.12 (PA2), U7.4 (GPIO0/CE)
TOF_XSHUT_R: R23.2, TP18.1, U3.13 (PA3), U8.4 (GPIO0/CE)
USB_CC1: J7.A5 (CC1), R27.1
USB_CC2: J7.B5 (CC2), R28.1
USB_C_DM: J7.A7 (D-), J7.B7 (D-), R31.1
USB_C_DP: J7.A6 (D+), J7.B6 (D+), R30.1
USB_DM: R31.2, U3.32 (PA11)
USB_DP: R30.2, R32.2, U3.33 (PA12)
USB_SHIELD: C41.1, J7.SH (SHIELD), R29.1
VBAT_RAW: J1.2, SW1.2 (B)
VBAT_SENSE: C7.1, R1.2, R2.1, U3.16 (PA6)
VBAT_SW: C1.1, C2.1, C3.1, C20.1, C21.1, C22.1, J6.1, R1.1, SW1.1 (A), TP1.1, U1.2 (EN), U1.3 (IN), U4.13 (VM2), U4.14 (VM3), U4.24 (VM1)
VBUS: J7.A4 (VBUS), J7.A9 (VBUS), J7.B4 (VBUS), J7.B9 (VBUS)

Notes on the sheet:
IMU & FLASH
USB & UI
MCU
POWER
RANGE SENSORS (ToF)
MOTORS & ENCODERS
OLED module: 0.96in SSD1306 128x64, I2C addr 0x3C, powered from +3V3. Bus is 2.8 V (pull-ups R18/R19 2.2k to +2V8). REMOVE the module's own SCL/SDA pull-ups. PCB: place J near the MCU, away from ToF I2C/XSHUT routing.
Menu buttons: idle LOW (10k pull-down + 100nF), press = +3V3. ENTER = FRONT.
